Chicken-Fried/STM32-NanoCortex/arm_tiny_pcb.jpg

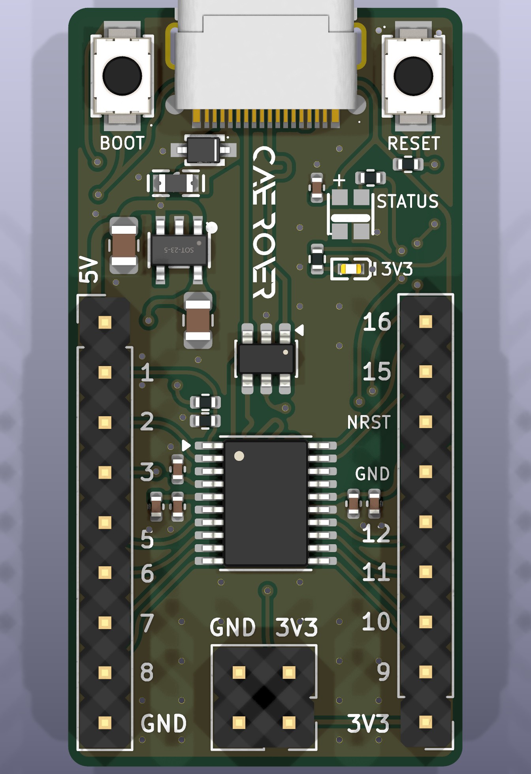
arm_tiny_pcb.jpg
