Chicken-Fried/STM32-NanoCortex/arm_tiny_pcb_sch.pdf

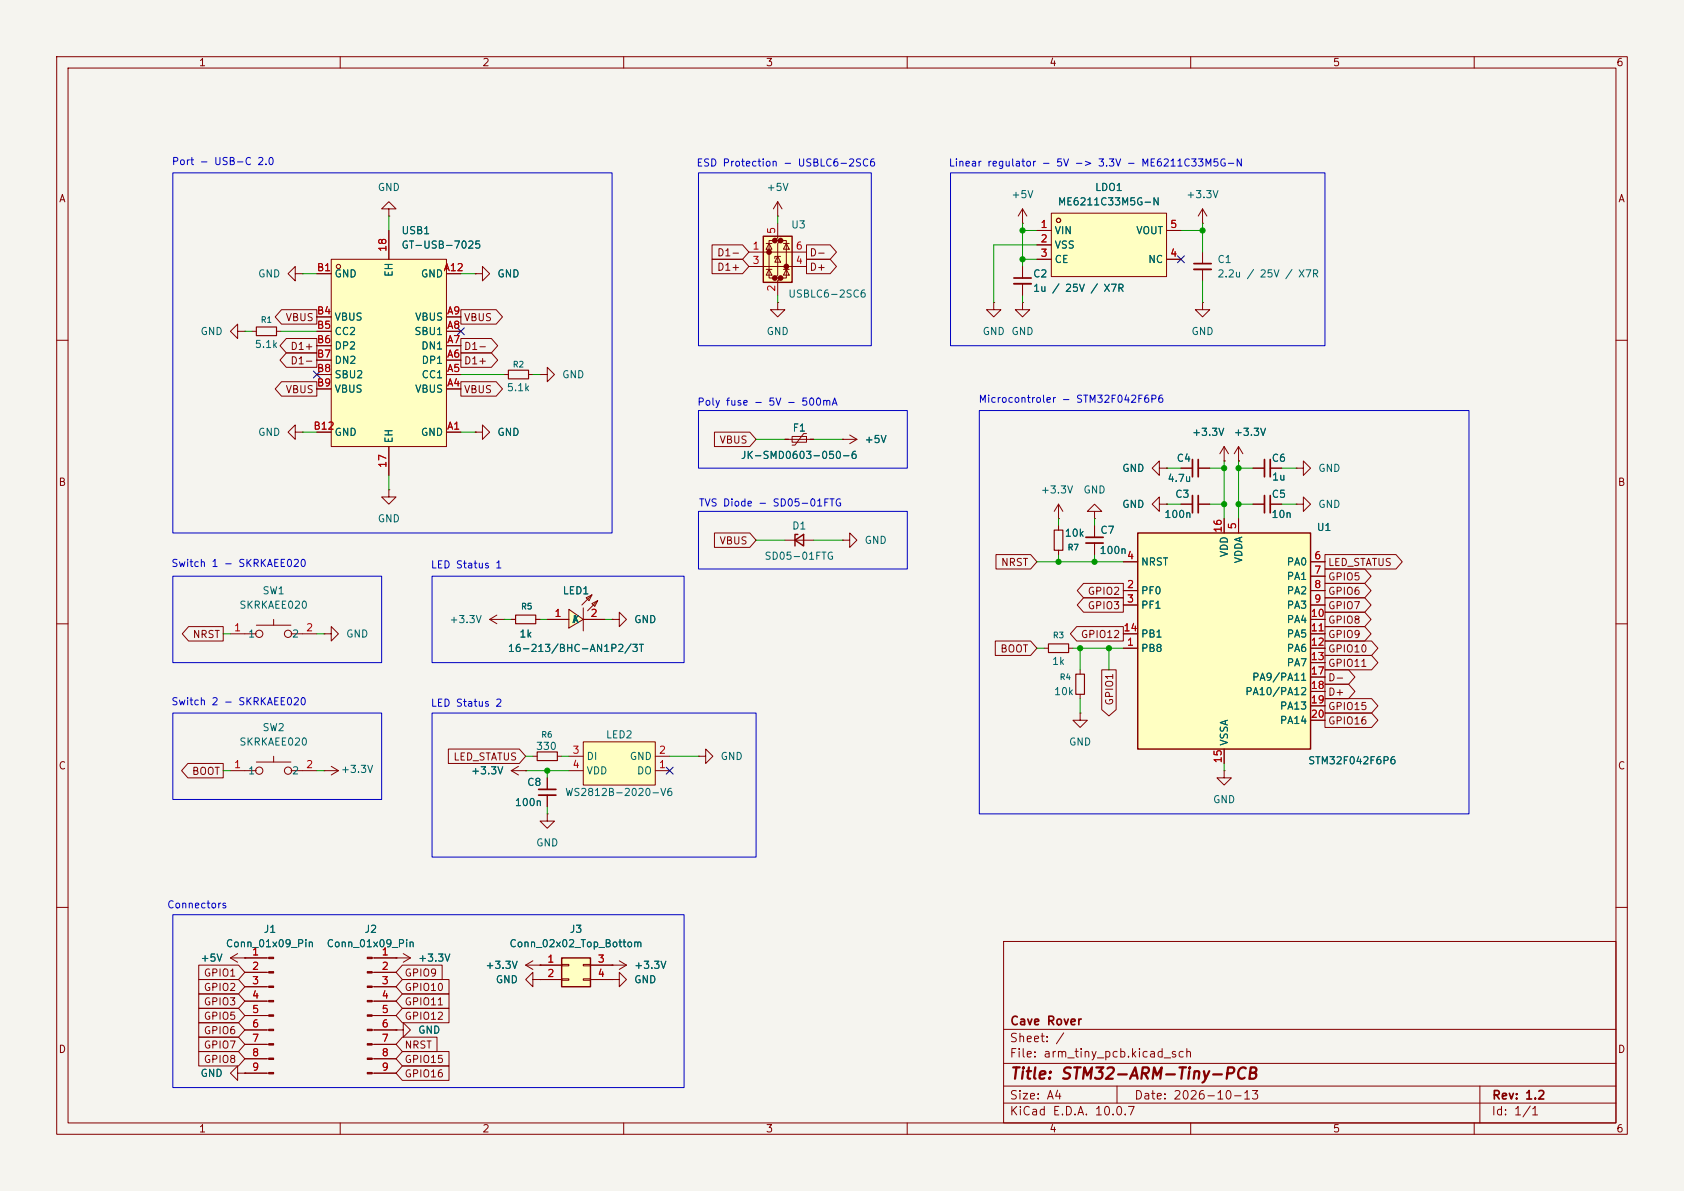
[picture p7: page 1]

Cave Rover
Sheet: /
File: arm_tiny_pcb.kicad_sch
Title: STM32-ARM-Tiny-PCB

Size: A4 | Rev: 1.2
KiCad E.D.A. 10.0.7 | Id: 1/1
