Chicken-Fried/STM32-NanoCortex/arm_tiny_pcb.kicad_pcb

## KiCad design arm_tiny_pcb.kicad_pcb (2026-10-28)

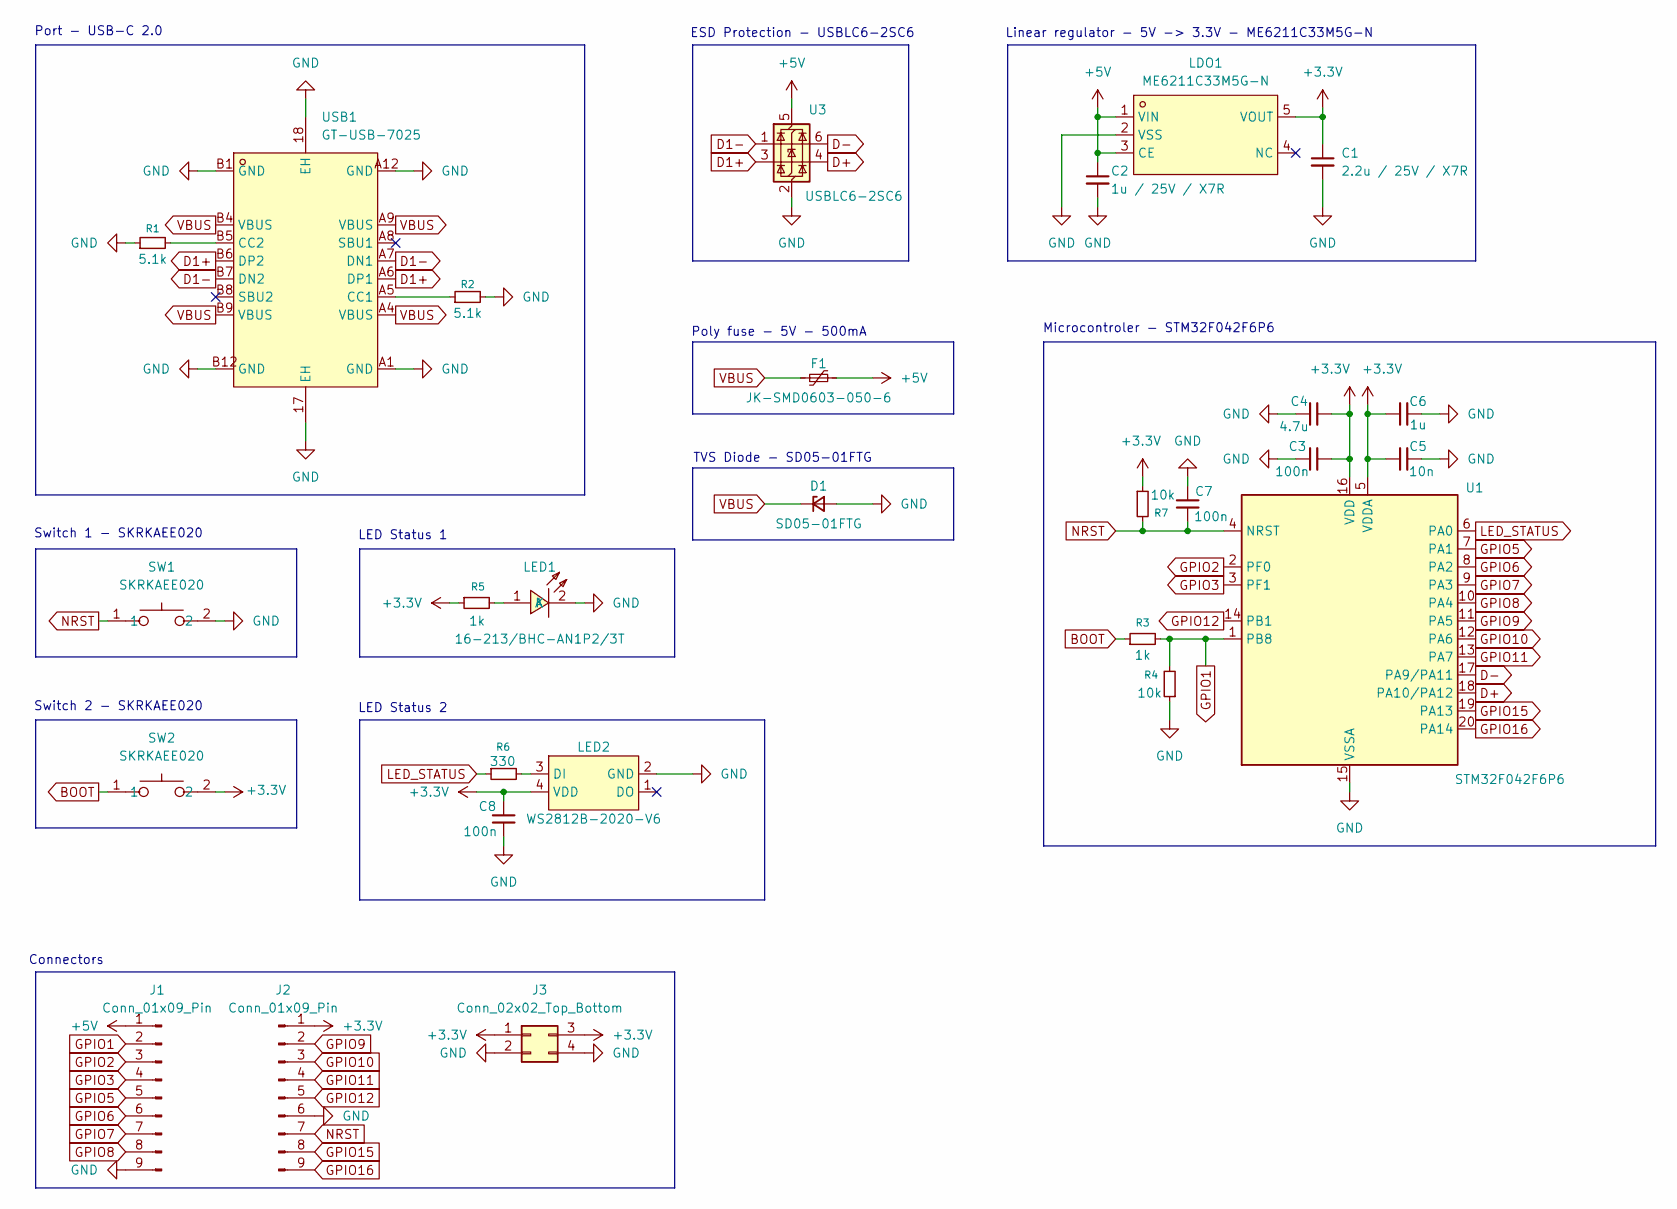
[picture p8: schematic arm_tiny_pcb.kicad_sch, STM32-ARM-Tiny-PCB]

Parts:
C1: 2.2u / 25V / X7R; C_0805_2012Metric; LCSC Part C22409262
C2: 1u / 25V / X7R; C_0805_2012Metric; LCSC Part C2171577
C3, C7, C8: 100n; C_0402_1005Metric
C4: 4.7u; C_0402_1005Metric; LCSC Part C368809
C5: 10n; C_0402_1005Metric; LCSC Part C307329
C6: 1u; C_0402_1005Metric; LCSC Part C29266
D1: SD05-01FTG; SOD-323_L1.8-W1.3-LS2.5-RD; LCSC Part C426873
F1: JK-SMD0603-050-6; F0603; LCSC Part C2832203
J1, J2: Conn_01x09_Pin; PinHeader_1x09_P2.54mm_Vertical; LCSC Part C42372501
J3: Conn_02x02_Top_Bottom; PinHeader_2x02_P2.54mm_Vertical; LCSC Part C124362
LDO1: ME6211C33M5G-N; SOT-23-5_L3.0-W1.7-P0.95-LS2.8-BL; MPN ME6211C33M5G-N; LCSC Part C82942
LED1: 16-213/BHC-AN1P2/3T; LED0402-R-RD; MPN 16-213/BHC-AN1P2/3T; LCSC Part C131223
LED2: WS2812B-2020-V6; LED-SMD_4P-L2.2-W2.0-P1.00_WS2815C-2020-4P; MPN WS2812B-2020-V6; LCSC Part C52917434
R1, R2: 5.1k; R_0402_1005Metric; LCSC Part C278598
R3, R5: 1k; R_0402_1005Metric; LCSC Part C71623
R4, R7: 10k; R_0402_1005Metric; LCSC Part C71617
R6: 330; R_0402_1005Metric; LCSC Part C140196
SW1, SW2: SKRKAEE020; SW-SMD_L3.9-W3.0-P4.45; MPN SKRKAEE020; LCSC Part C115357
U1: STM32F042F6P6; TSSOP-20_4.4x6.5mm_P0.65mm; LCSC Part C81000
U3: USBLC6-2SC6; SOT-23-6; LCSC Part C7519
USB1: GT-USB-7025; TYPE-C-SMD_GT-USB-7025; MPN GT-USB-7025; LCSC Part C963213

Connections:
+3.3V: C1.1, C3.2, C4.2, C5.1, C6.1, C8.2, J2.1, J3.1, J3.3, LDO1.5 (VOUT), LED2.4 (VDD), R5.1, R7.1, SW2.2, U1.5 (VDDA), U1.16 (VDD)
+5V: C2.1, F1.2, J1.1, LDO1.1 (VIN), LDO1.3 (CE), U3.5 (VBUS)
BOOT: R3.1, SW2.1
D1+: U3.3 (I/O2), USB1.A6 (DP1), USB1.B6 (DP2)
D1-: U3.1 (I/O1), USB1.A7 (DN1), USB1.B7 (DN2)
D+: U1.18 (PA10/PA12), U3.4 (I/O2)
D-: U1.17 (PA9/PA11), U3.6 (I/O1)
GND: C1.2, C2.2, C3.1, C4.1, C5.2, C6.2, C7.2, C8.1, D1.2 (A), J1.9, J2.6, J3.2, J3.4, LDO1.2 (VSS), LED1.2 (K), LED2.2 (GND), R1.1, R2.2, R4.1, SW1.2, U1.15 (VSSA), U3.2 (GND), USB1.17 (EH), USB1.18 (EH), USB1.A1 (GND), USB1.A12 (GND), USB1.B1 (GND), USB1.B12 (GND)
GPIO1: J1.2, R3.2, R4.2, U1.1 (PB8)
GPIO2: J1.3, U1.2 (PF0)
GPIO3: J1.4, U1.3 (PF1)
GPIO5: J1.5, U1.7 (PA1)
GPIO6: J1.6, U1.8 (PA2)
GPIO7: J1.7, U1.9 (PA3)
GPIO8: J1.8, U1.10 (PA4)
GPIO9: J2.2, U1.11 (PA5)
GPIO10: J2.3, U1.12 (PA6)
GPIO11: J2.4, U1.13 (PA7)
GPIO12: J2.5, U1.14 (PB1)
GPIO15: J2.8, U1.19 (PA13)
GPIO16: J2.9, U1.20 (PA14)
LED_STATUS: R6.1, U1.6 (PA0)
NRST: C7.1, J2.7, R7.2, SW1.1, U1.4 (NRST)
unnamed: LED1.1 (A), R5.2
unnamed: LED2.3 (DI), R6.2
unnamed: R2.1, USB1.A5 (CC1)
unnamed: R1.2, USB1.B5 (CC2)
VBUS: D1.1 (K), F1.1, USB1.A4 (VBUS), USB1.A9 (VBUS), USB1.B4 (VBUS), USB1.B9 (VBUS)

Notes on the sheet:
Poly fuse - 5V - 500mA
LED Status 2
Switch 1 - SKRKAEE020
LED Status 1
Microcontroler - STM32F042F6P6
TVS Diode - SD05-01FTG
Switch 2 - SKRKAEE020
Linear regulator - 5V -> 3.3V - ME6211C33M5G-N
Connectors
Port - USB-C 2.0
ESD Protection - USBLC6-2SC6

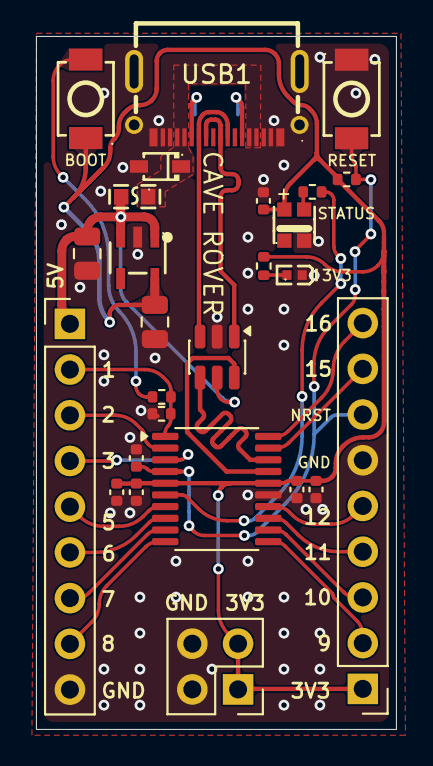
[picture p9: board arm_tiny_pcb.kicad_pcb from above]

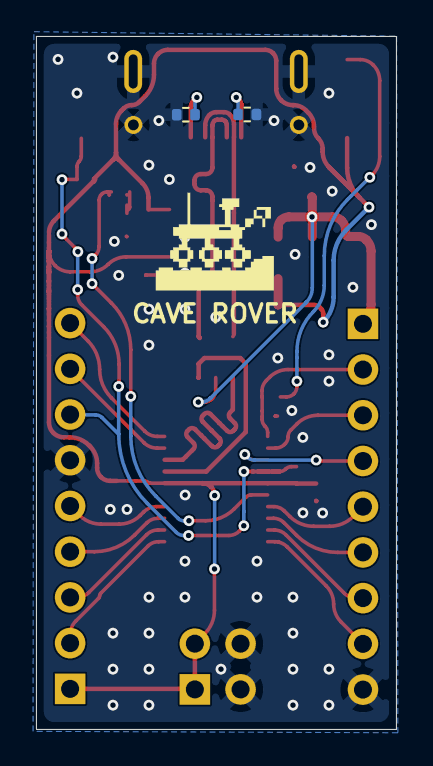
[picture p10: board arm_tiny_pcb.kicad_pcb from below]

Board: 2 copper layers, 20.0 x 38.5 mm, 29 parts (3 on the bottom side), 28 nets.

Other parts of the board:
LOGO**: Logo_CavityRover_F_SilkS; Logo_CavityRover
