Chicken-Fried/STM32-NanoCortex/(commit log)

2026-10-11 Hardware Rev 2: 20x38.5mm, TVS protection, ME6211 LDO & portable libs
    Major hardware revision, project library centralization, and documentation overhaul:
    1. Hardware & PCB:
    - Updated board dimensions to 20 mm × 38.5 mm (compact, breadboard-friendly layout).
    - Added SD05-01FTG TVS diode (SOD-323) on VBUS for ESD and transient surge protection.
    - Replaced LDO regulator with low-noise, low-Iq ME6211C33M5G-N (SOT-23-5).
    - Replaced tantalum capacitors with MLCC X7R 0805 ceramic capacitors (C1 2.2 µF & C2 1 µF).
    - Updated resistor footprints to standard 0402 package (R_0402_1005Metric).
    - Optimized power routing, ground stitching vias, and bottom GND return planes.
    2. KiCad Libraries & Porta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
    [arm_tiny_pcb.kicad_pcb, arm_tiny_pcb.kicad_sch]
2026-10-13 feat(hw): upgrade RGB LED to WS2812B-V6, expose 5V/NRST & introduce CaveRover branding
    - Update on-board RGB status LED from SK6805 to WS2812B-2020-V6 for native 3.3V operation
    - Add 100 nF decoupling capacitor (C8) adjacent to WS2812B VDD pin
    - Update header pinout:
    * Expose protected 5V rail on J1 pin 1 (post-polyfuse F1) for drone receivers and external sensors
    * Expose dedicated hardware NRST on J2 pin 7 for ST-Link "Connect Under Reset" support
    * Complete standard 4-wire SWD debug header (GND, NRST, SWDIO, SWCLK)
    - Introduce CaveRover project branding:
    * Add vertical "CAVEROVER" silkscreen text styled in Anurati futuristic font
    * Add custom 8-bit pixel art silkscreen logo foot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
    [arm_tiny_pcb.kicad_pcb, arm_tiny_pcb.kicad_sch]
2026-10-13 Update 3D board renders, schematic exports and branding for rev 1.2
    - Regenerate schematic export arm_tiny_pcb_sch.pdf and schematic_preview.png with rev 1.2 title block
    - Re-render raytraced top view (docs/board_3d.jpg, arm_tiny_pcb.jpg) and isometric perspective (docs/board_3d_iso.jpg)
    - Add bottom 3D view (docs/board_3d_back.jpg) highlighting the CaveRover rover logo footprint
    - Update README and README_FR hero gallery to display top, bottom, and isometric views
2026-10-28 chore: relicense to CERN-OHL-S v2 & ignore production build outputs
    - Update license to CERN-OHL-S v2 across LICENSE and READMEs\n- Add production/, gerber_to_order/ to .gitignore\n- Refill copper zones and teardrops on PCB
    [arm_tiny_pcb.kicad_pcb]
